pgratz1/pcie-matmul-rtl2gds/docs/session-logs/README.md

# Session logs

Full transcripts of the multi-agent run that took this design from an empty
repository to a signed-off GDS-II. Rendered from the raw Claude Code session
transcripts into readable Markdown.

**3,042 turns across eight participants.** Tool output is truncated at 2,500
characters per call and long text blocks at 20,000; model reasoning is preserved
in collapsed `<details>` blocks. Credentials are redacted.

| Log | Participant | Phases | Turns |
|-----|---|---|---|
| [00-orchestrator.md](00-orchestrator.md) | Orchestrator (main session) | 0–5 | 510 |
| [01-validation-specialist-phase0.md](01-validation-specialist-phase0.md) | validation-specialist | 0 | 104 |
| [02-spec-writer.md](02-spec-writer.md) | spec-writer | 1–3 | 282 |
| [03-rtl-designer.md](03-rtl-designer.md) | rtl-designer | 2–4 | 284 |
| [04-test-writer.md](04-test-writer.md) | test-writer | 2–3 | 483 |
| [05-rtl-reviewer.md](05-rtl-reviewer.md) | rtl-reviewer | 2b | 93 |
| [06-validation-specialist.md](06-validation-specialist.md) | validation-specialist | 3–4 | 743 |
| [07-circuit-designer.md](07-circuit-designer.md) | circuit-designer | 4 | 543 |

## How the process worked

The orchestrator wrote no RTL, tests or flow scripts. It delegated to six
subagents, enforced the phase gates in [`CLAUDE.md`](../../CLAUDE.md), and
independently re-verified every gate claim rather than accepting agent reports.

The RTL author and the test author worked **in parallel from the specification
alone**, neither able to see the other's work. That independence is what surfaced
six specification under-determinations in Phase 2 and made the test suite a real
check rather than a restatement of the implementation.

## Where the interesting parts are

- **BUG-007**, the defect that nearly shipped — a Yosys `peepopt` peephole
  mis-compiled legal RTL, so the *synthesized* design computed one matrix row as
  always zero while all 72 RTL tests passed. Found in
  [06-validation-specialist.md](06-validation-specialist.md) during gate-level
  simulation; root-caused in [03-rtl-designer.md](03-rtl-designer.md).
- **BUG-001**, which invalidated a phase of evidence — `make test N=<n>` never
  rebuilt the simulation binary, so every earlier "passes at N=4/N=16" result was
  the N=8 binary re-run. [06-validation-specialist.md](06-validation-specialist.md).
- **Three refuted hypotheses**, each overturned by measurement rather than
  argument: the reviewer's `WIDTHCONCAT` call and its cell-delta theory (both in
  [03-rtl-designer.md](03-rtl-designer.md)), and the orchestrator's own root-cause
  guess for BUG-007.
- **Two spec requirements that were arithmetically impossible** as written,
  caught by the test author being unable to write a test for them
  ([04-test-writer.md](04-test-writer.md), [02-spec-writer.md](02-spec-writer.md)).

See [`../phase-reports/summary.md`](../phase-reports/summary.md) for the sign-off
summary, final numbers, and what the process would change next time.
