pgratz1/pcie-matmul-rtl2gds/docs/phase-reports/phase2-review-round2.md

# Phase 2b RTL Review — Round 2 (deltas only) — `rtl/` v. `docs/spec.md` 1.1.2

## Blocking

**None.** All six round-1 items are correctly actioned, the `mem_c` reset rewrite is exhaustively correct at every legal `N`, and the `cfg_len_ok` reasoning holds as claimed. Nothing in the rework disturbs anything I verified clean in round 1.

## Should fix

1. **`rtl/mem_c.sv:92-94` — the +1,178 cell delta is most plausibly here, not in `cfg_len_ok`.** The loop index is `ri[BOW-1:0] * BOW'(N*ACCW)` where `ri` is a module-scope `integer` (`mem_c.sv:81`). That is a *sized arithmetic expression on a variable*, which is exactly the form that discourages constant folding; if Yosys does not fold it, the reset branch synthesises a second variable-offset row-write decoder alongside the existing `d_boff` one at `mem_c.sv:96`. At N=8 that decoder spans 8 rows × 256 bits — the right order of magnitude for ~1,200 combinational cells at unchanged flop count. The alternative explanations do not add up: `cfg_len_ok` is one 10-bit equality (~10 cells) and the deleted sinks were already dead-code-eliminated. Diagnostic: `yosys -p "read_verilog -sv $(cat rtl/filelist.f); hierarchy -top matmul_top; synth; select mem_c; stat"`. Fix, behaviour-identical: declare the variable in the block and drop the casts — `for (int ri = 0; ri < NROW; ri++) mem[ri*N*ACCW +: N*ACCW] <= '0;` — which elaborates to `NROW` constant part-selects. Area only; forward to the Phase 4 brief if not taken now.
2. **REQ-126 and REQ-123 are claimed by no module header.** `tlp_rx.sv:36-41` implements REQ-126 at `tlp_rx.sv:198,221` but does not claim it; `matmul_top.sv:48` claims REQ-122 but not its companion REQ-123 (which `mm_ctrl`/`reg_file` jointly satisfy). Item 6 of the rework added 13 claims and missed the two newest. Comment-only.
3. **`rtl/mm_array.sv:61-65`** — the `UNUSEDSIGNAL` suppression wraps the whole `a_o`/`b_o`/`v_o` declarations, not just the edge bits that are unread by construction. A future mis-index of the chain at `mm_array.sv:82-83,90-91` would no longer be caught by lint. Verilator offers no narrower scope, so accept it, but the loss of coverage on those three vectors is real and should be recorded.

## Coverage gaps

- **REQ-042 vs REQ-126 textual overlap** (`docs/spec.md:729-731` vs `:737-749`). REQ-042's antecedent — "a `CfgRd0`/`CfgWr0` whose Device or Function Number is non-zero" — still literally matches a malformed-`Length` request to a non-zero device and forbids `ERR_UNSUP_REQ`, while REQ-126 requires it. REQ-126's closing sentence asserts precedence and the RTL follows REQ-126, so behaviour is unambiguous; but REQ-042's own text was not amended. → spec-writer: add "with `Length` == 1" to REQ-042's antecedent.
- **`rtl/mem_c.sv:79`** — `NROW = (1<<WIW)/N` is an exact tiling only because `N` is a power of two, so `1<<$clog2(N*N) == N*N`. Guaranteed by §14, but the code carries no note; a non-power-of-two `N` would leave the tail of `mem` unreset with no lint or test failure. → rtl-designer: one-line comment, optional.

## Verified clean

- **`mem_c` reset coverage (item 1) — exhaustive, no off-by-one.** Because `N` is a power of two, `1<<WIW == NW == N*N` exactly, so `NROW == N` and the `N` fills of `N*ACCW` bits tile `MEMBITS` with no gap and no overlap. Checked every legal `N`: N=2 → MEMBITS 128, NROW 2, row 64 b, last fill 64+64=128; N=4 → 512, 4, 128 b, 384+128=512; N=8 → 2048, 8, 256 b, 1792+256=2048; N=16 → 8192, 16, 512 b, 7680+512=8192; N=32 → 32768, 32, 1024 b, 31744+1024=32768. `BOW` (7/9/11/13/15) never truncates the offset product at any `N`. Every word of `mem_c` is cleared; §13.4 and REQ-092 hold.
- **`cfg_len_ok` (item 3) — the structural claim is correct, verified independently.** A config TLP with `Length != 1` fails the guard at `tlp_rx.sv:221`, then fails `is_mem && fmt_3dw` at `:225` (`ttype == 5'b00100`), and lands on the terminal `else` at `:229`. There `posted = is_msg || ((is_mem||is_io) && fmt_wr)` is 0 for `ttype == 00100` on all three terms, so it resolves to `CLS_UR_ERR`, and `ev_unsup_req` at `:233` pulses on exactly that class — REQ-126(a) and (d). `cfg_req_valid` is asserted only in `S_CFGACC`, which is unreachable from `CLS_UR_ERR`, so no config register is touched and `cid` is not captured — REQ-126(b), consistent with REQ-052's "accepted" wording. The devfn test is inside the accepted branch, so the REQ-042 carve-out is bypassed as REQ-126 requires. Drain: `after_hdr` sends a `CfgWr0` (payload present, so no `eop` on DW2) to `S_DRAIN`, which holds `rx_tlp_ready` high and consumes to `eop` before `S_CPL` — REQ-126(c), no desynchronisation; a `CfgRd0` with bad `Length` has `eop` on DW2 and goes straight to `S_CPL`. Checked `Length` = 0 (1024 DW) and `Length` = 1023: both drain correctly. The UR header matches REQ-126's worked example bit-for-bit: `tlp_tx.sv:101-115` yields DW0 `0x0A000000` (Fmt 000/Type 01010, Length 0) and DW1 `0x00002004` (CID 0, Status 001, BCM 0, Byte Count 4).
- **REQ-122 (`D_WR` = 1, invariant).** All four region strobes (`app_bar0.sv:141-144`) are combinational from the accepted payload beat and commit on the edge ending it, so `t_commit = t_beat + 1` regardless of region, burst position, Byte Enables or `N`. The one path that could have made it region-dependent — `mem_c`'s drain-over-host priority at `mem_c.sv:95-97` — cannot drop a host write, because `c_wr` is gated `&& !eng_busy` and `d_wr_en` only asserts while busy.
- **REQ-123 (`t_beat + 4N + 2`, no `D_WR` term).** `reg_file.sv:112` drives `start` combinationally from the write beat, so `t_start == t_beat`; `mm_ctrl` enters `PRIME` on the edge ending `t_beat`, `done_set` asserts on the last `DRAIN` cycle `t_beat+4N+1`, and `STATUS.DONE` reads 1 during `t_beat+4N+2` (34 at N=8). `PERF_CYCLES` independently latches `cyc_cnt+1 = 4N+2`. Agrees with REQ-074/101 with no double-count.
- **REQ-124.** `reg_file.sv:115` suppresses `start_while_busy` at source when bit 1 is also set; `ERR_START_BUSY` reads 0 afterwards, and `soft_reset` takes full effect. Matches REQ-124's "not observable / not constrained" framing.
- **REQ-125.** `clr_acc = (state == ST_PRIME) || soft_reset` (`mm_ctrl.sv:214`) and `c_wr_en = (state == ST_DRAIN)` mean the row in flight on the `soft_reset` cycle still commits, with the correct `acc_south` value (the PE clear happens on the same edge but `acc_out` is the pre-edge register). Rows are written whole, so every `mem_c` word holds either its pre-operation value or its correct new value — never a partial or undefined one.
- **`tlp_tx.sv:160-163`** — `tx_tlp_data` now forced to `32'h0` under `rst` alongside sop/eop/valid; §13.4 reset row satisfied. No latch introduced (all four outputs still have unconditional defaults at `:132-135`).
- **Port removal (item 5)** — `rdata_last` gone from `app_bar0`'s port list; `rd_last_r` retained internally (`app_bar0.sv:108`) and still drives the `S_RD` exit, so the read burst still terminates correctly. `matmul_top` has no sink net left, restoring strict REQ-011.
- **Suppressions (item 2)** are as narrow as described: `mm_array.sv:61-65`, `tlp_rx.sv:139-142`, `pcie_cfg_space.sv:43-45` each wrap declarations only, each has a one-line justification, and each covers a signal that is genuinely unread by construction — `dw0_r`/`dw2_r`'s ignored header bits are the §7.2.1/7.2.2 don't-cares, and `req_wdata[13:8]` lands on RO-0 config fields. None hides a signal that should be driving something.
