pgratz1/pcie-matmul-rtl2gds/docs/bugs.md

# Bug ledger — PCIe-attached matrix multiplier

Owner: validation-specialist (CLAUDE.md "Ownership and independence rules").
Opened during Phase 3 validation.

Format: `BUG-nnn | test | REQ ids | status | symptom | root cause | fix | files`

Status values: `OPEN`, `ROUTED-rtl`, `ROUTED-test`, `ROUTED-spec`, `CLOSED`,
`CLOSED-nofix` (investigated, no defect).

**Close-out policy.** A bug is only marked `CLOSED` after I have re-verified it
independently of the owner's report. For the three "a test assumed `N` = 8
magnitudes" bugs (002, 003, 005) a passing test is *not* sufficient evidence —
a test can pass because it now checks less. Each of those was closed only after
**mutation testing**: a deliberate, lint-clean RTL defect of the exact class the
test exists to catch was injected into a scratch copy of `rtl/`, and the
repaired test was required to **fail**. `rtl/` itself was never modified.

### Mutation set used for close-out

All mutants are lint-clean under `verilator --lint-only -Wall` and live in the
scratchpad, built via `make test VERILOG_SOURCES=<mutant filelist>`.

| ID | Injected defect | File | Kills |
|----|---|---|---|
| M1 | `!eng_busy` dropped from `a_wr`/`b_wr`/`c_wr` — host writes land during an operation | `app_bar0.sv:142-144` | BUG-003's test |
| M2 | `c_wr_row = drn_cnt` instead of `N-1-drn_cnt` — drain rows emitted in reverse | `mm_ctrl.sv:221` | BUG-005's test |
| M3 | drain lanes reversed on the way into storage | `mem_c.sv` | BUG-005's test |
| M4 | a BAR0 write beat immediately following another is dropped | `app_bar0.sv` | **nothing — invalid mutant**, see BUG-002 |
| M5 | a `sop` arriving the cycle after an `eop` is ignored — gapless TLPs misframed | `tlp_rx.sv:349` | BUG-002's test |
| M6 | `rx_tlp_ready` held low 40 cycles after every `eop` — pushes a write beat outside the BUSY window | `tlp_rx.sv:161` | BUG-003's positioning guard |
| M7 | `len_ok` accepts `Length` field 0 | `tlp_rx.sv:200` | REQ-127's test |
| M8 | `len_ok` accepts decoded length > 32 | `tlp_rx.sv:200` | REQ-127's test |

---

## BUG-001 — `make test N=<n>` silently reuses a stale `sim.vvp`

| field | value |
|---|---|
| **test** | whole suite; `tb/Makefile` |
| **REQ ids** | REQ-113 (`matmul_top` parameterizable for every legal `N`), and the Phase 3 gate's "100% of tests pass" (which was only ever measured at `N` = 8) |
| **status** | **`CLOSED` 2026-09-11** |
| **found by** | Noticing that 16 consecutive `make -C tb test N=<2,4,8,16>` runs all took 19–20 s and never changed `tb/sim_build/sim.vvp`'s mtime. |

**Symptom.** `make -C tb test N=2` reports `TESTS=71 PASS=71 FAIL=0`. After
`make -C tb clean`, the identical command reports `PASS=69 FAIL=2`. The `N`
override had no effect at all; every "sweep" run was the previously built
`N = 8` binary.

**Root cause.** cocotb's `Makefile.icarus` declares
`$(SIM_BUILD)/sim.vvp: $(VERILOG_SOURCES) ...`. `N` reaches the compile through
`COMPILE_ARGS += -P$(COCOTB_TOPLEVEL).N=$(N)` (tb/Makefile line ~76), which is
**not** a prerequisite of that rule. When the RTL sources are unchanged, make
considers `sim.vvp` up to date and re-runs the old binary under the new `N=`
variable. The same hazard applies to `SEED` (harmless, `SEED` is read at
runtime) and to any future `COMPILE_ARGS` knob (not harmless).

This is why `rtl/README.md` can truthfully say "clean at N = 2, 4, 8, 16 and
32" — `make lint` and `make elab-sweep` re-invoke verilator/iverilog every time
and are unaffected — while the *simulation* at those `N` had never actually
run.

**Fix (recommended, for test-writer).** Make the build depend on the
parameterization, e.g. stamp `N` into the build directory
(`SIM_BUILD := $(TB_DIR)/sim_build/n$(N)`), or add an order-only prerequisite
file whose contents are `$(N)`. A `SIM_BUILD` per `N` also lets the `N` sweep
run in parallel.

**Files.** `tb/Makefile`.

**Impact.** This bug is what hid BUG-002 and BUG-003. It is the single most
important finding of Phase 3: the gate criterion "100% of tests pass" was being
evaluated against a binary that did not correspond to the requested
configuration.

### Close-out verification (validation-specialist, 2026-09-11)

**Fix as delivered.** `SIM_BUILD := $(TB_DIR)/sim_build/$(SIM)-n$(N)` with
`COCOTB_RESULTS_FILE := $(SIM_BUILD)/results.xml`, plus a `check-build-id`
prerequisite on `sim-guard` and a `make build-id` reporter.

**Verified functionally.** Deleted `tb/sim_build` entirely, then ran
`make test N=<n> TEST=test_smoke` for n = 2, 4, 8, 16 with **no `make clean`
anywhere**. Four separate binaries were produced and all four passed:

| `N` | `sim.vvp` md5 (first 12) | result |
|---|---|---|
| 2 | `688715e0a6ab` | 4/4 |
| 4 | `b3a594814a14` | 4/4 |
| 8 | `0f7196821ba8` | 4/4 |
| 16 | `63f5e5169130` | 4/4 |

4 distinct hashes from 4 runs; 4 isolated `results.xml`. These match the hashes
the orchestrator reported, arrived at independently.

**Guard attacked, per the brief.** Seven attempts to make `check-build-id`
accept a `SIM_BUILD` that does not encode `N`:

| Attempt | Outcome |
|---|---|
| `SIM_BUILD=/tmp/att-nope N=2` | blocked |
| `SIM_BUILD=.../icarus-n8 N=2` (another `N`'s dir) | blocked |
| `SIM_BUILD=/tmp/att-n2/ N=2` (trailing slash) | blocked |
| `SIM_BUILD=/tmp/att-n32 N=2` (suffix-collision attempt) | blocked |
| `SIM_BUILD=/tmp/att-n2 N=32` (reverse collision) | blocked |
| `SIM_BUILD=.../icarus-n2 N=2` | allowed — correct, encodes `N` |
| `SIM_BUILD=/tmp/junk-n2 N=2` | allowed — correct, encodes `N` |

The `*n$(N)` suffix glob is not defeatable by the legal `N` values: no two of
`n2, n4, n8, n16, n32` are suffixes of one another. The guard is real, not
decorative.

**One residual hole, reported not reopened.** `check-build-id` hangs off
`sim-guard`, which is a prerequisite of `test` (and therefore of `waves`). It is
**not** a prerequisite of `sim`, the target cocotb's `Makefile.sim` contributes.
`make -C tb sim N=2 SIM_BUILD=/tmp/bypass-nope` runs unguarded and builds in
`/tmp/bypass-nope` — confirmed empirically. This is narrow: `sim` is not a
documented entry point (`CLAUDE.md` and the Makefile's own `usage` text list
only `lint`/`test`/`waves`/`elab-sweep`), and even via `sim` the *default*
`SIM_BUILD` still encodes `N`, so a user must explicitly override `SIM_BUILD`
to hurt themselves. **Suggested one-line follow-up for test-writer:
`sim: check-build-id`.** Not a reason to hold the bug open.

**Closed.** The hazard is fixed, the guard works on every documented path, and
the `N` sweep now genuinely tests what it claims.
---

## BUG-002 — `test_tlp_back_to_back_tlps_no_idle_cycles` hard-codes 16 DWORDs into `mem_c`

| field | value |
|---|---|
| **test** | `tb/tests/test_tlp.py::test_tlp_back_to_back_tlps_no_idle_cycles` (line ~771) |
| **REQ ids** | test cites REQ-005/REQ-013/REQ-022; the behaviour it trips over is REQ-091 |
| **status** | **`CLOSED` 2026-09-11** |
| **found by** | Full suite at `N = 2` after `make clean` (BUG-001), SEED = 1, 7, 424242, 20260910 — fails on all four, so it is deterministic, not seed-dependent. |

**Symptom.**
```
AssertionError: REQ-022: DWORD(s) [4, 5, 6, 7, 8, 9, 10, 11, 12, 13, 14, 15]
did not land when the 16 single-DWORD MWr TLPs were issued one at a time ...
read back 0000111101001111020011110300111100000000...0
```
DWORDs 0–3 land correctly; 4–15 read back as zero.

**Root cause — in the test, not the DUT.** The test does
`pattern = [0x11110000 + k for k in range(16)]` and `base = G.MEM_C_BASE`,
i.e. it writes 16 DWORDs into the C region unconditionally. `mem_c` holds
`N*N` words (spec §9.2, §11.3). At `N = 2` that is **4** words, so DWORDs 4–15
are at BAR0 offsets ≥ `0x3010` which REQ-091 makes RAZ/WI. The DUT is doing
exactly what REQ-091 requires. The constant 16 happens to be ≤ `N*N` for
`N` ≥ 4, which is why the bug only appears at `N = 2`.

**Fix (recommended, for test-writer).** The test already calls `discover_n(tb)`
and throws the result away. Scale the burst: `count = min(16, n * n)` (or pick
a region that is `N`-independent — the `reg_file` region is 4 KiB for every
`N`). **Do not** relax the assertion.

**Files.** `tb/tests/test_tlp.py`.

### Close-out verification (validation-specialist, 2026-09-11)

**Fix as delivered.** The 16 writes cycle through implemented C words
(`word = k mod N*N`), so the TLP count — and therefore the back-to-back stress
— is identical at every `N`, and several TLPs now target the same address.

**Verified it still catches its bug class, not just that it passes.** A test
that passes because it checks less would be worse than the original, so the
repaired test was run against deliberately broken RTL.

- **M4 (first attempt) — survived, and the mutant was wrong, not the test.**
  I first injected "drop a BAR0 write beat that immediately follows another
  write beat". The test passed. Root cause of the *mutant's* failure: for
  single-DWORD `MWr` TLPs the payload beats are separated by three header
  beats, so `wr_beat` is never asserted on two consecutive cycles and the
  mutation is unreachable. Recorded because a surviving mutant must be
  explained, not ignored.
- **M5 — killed at `N` = 2 and `N` = 8.** Injected into `tlp_rx.sv:349`: a
  `sop` arriving on the cycle immediately after an `eop` is ignored, which is
  precisely the gapless-framing property (REQ-005/REQ-020) this test exists to
  protect. The test failed at both `N` with the on-point diagnostic:
  > `REQ-005/REQ-013: C word(s) [0, 1, 2, 3] of 4 did not take effect when 16
  > single-DWORD MWr TLPs were presented back-to-back with no idle cycle
  > between eop and the next sop (the identical writes with idle cycles
  > between them all landed).`

The repaired test keeps its teeth and its error message still names the right
requirement. Also passes unmodified at `N` = 2, 4, 8, 16.

**Closed.**
---

## BUG-003 — `test_matmul_write_abc_while_busy` assumes the operation outlives the TLP stream

| field | value |
|---|---|
| **test** | `tb/tests/test_matmul.py::test_matmul_write_abc_while_busy` (line ~167) |
| **REQ ids** | REQ-062, REQ-101/REQ-123 |
| **status** | **`CLOSED` 2026-09-11** |
| **found by** | Full suite at `N = 2` after `make clean`; root-caused from an FST dump correlating `rx_tlp_*` beats with `eng_busy` and `eng_c_wr_en`. |

**Symptom.** `C after A/B/C writes were attempted while BUSY: 1 of 4 elements
differ: [0][0]: DUT -1 != golden -5720`. `-1` is `0xFFFFFFFF`, the value the
test wrote. The companion assertions in the same test (`ERR_WRITE_BUSY` set,
`mem_a` preserved) both **pass**.

**Root cause — in the test, not the DUT.** The test issues one burst of four
TLPs: `CTRL.START`, then `MWr` to A, B and C. Each single-DWORD `MWr` is 4
beats, so the payload beats land roughly 4 cycles apart. An operation takes
`4N + 2` cycles (REQ-101), which at `N = 2` is **10** cycles — shorter than the
TLP stream that is trying to race it. Waveform, `N = 2`, SEED = 7
(period 10 ns):

| time | event | `eng_busy` |
|---|---|---|
| 4250 ns | `CTRL.START` payload beat | 0 → 1 next cycle |
| 4300 ns | `MWr` A payload beat (`addr 0xc0001000`, `0xFFFFFFFF`) | **1** → discarded, `ERR_WRITE_BUSY` set |
| 4350 ns | `MWr` B payload beat (`addr 0xc0002000`) | **1** → discarded |
| 4330, 4340 ns | `eng_c_wr_en` — both rows of C drained | 1 |
| 4350 ns | `eng_busy` → 0 (operation complete, `4N+2 = 10` cycles after 4250) | |
| 4400 ns | `MWr` C payload beat (`addr 0xc0003000`, `0xFFFFFFFF`) | **0** |

The C write arrives 5 cycles **after** `BUSY` fell. REQ-062 gates the discard
on `STATUS.BUSY == 1`; `BUSY` was 0, so accepting the write is the specified
behaviour, and it lands on top of the already-drained `C[0][0]`. At `N = 8`
the operation is 34 cycles and still running when the C write arrives, which
is why the test passes there.

**Fix (recommended, for test-writer).** Make "still busy" an explicit
precondition rather than an accident of `N`: either hold `rx_tlp_ready`-side
pacing so all three writes are in flight before `4N+2` elapses, or read
`STATUS` between the writes and assert `BUSY == 1` at the moment of each write,
or drive the three A/B/C writes as **one** multi-DWORD burst instead of three
TLPs. **Do not** drop the C check or widen the tolerance.

**Files.** `tb/tests/test_matmul.py`.

### Close-out verification (validation-specialist, 2026-09-11)

**Fix as delivered.** Each region is raced separately against a fresh `START`,
and the shim's recorded beat cycles now assert
`1 <= t_write - t_start <= 4*N + 2`.

**The specific thing I flagged was "the test silently tests nothing when the
operation has already finished". That is the claim I verified, and a passing
run cannot demonstrate it** — I had to make the write land outside the window
and confirm the test *fails loudly* rather than passing.

- **M6 — the positioning guard fires.** Injected into `tlp_rx.sv:161`:
  `rx_tlp_ready` held low for 40 cycles after every `eop`. This is legal
  sink behaviour under REQ-002, so nothing else breaks; it simply pushes the
  poison write's payload beat far past the BUSY window. At `N` = 2 **and**
  `N` = 8 the test failed with exactly the intended message:
  > `test positioning: the mem_a write's payload beat transferred 45 cycles
  > after the CTRL.START beat, outside the BUSY window [1, 4*N+2 = 10] that
  > REQ-074 defines. REQ-062 only applies while STATUS.BUSY is 1, so this run
  > would not have exercised it.`

  Under the old test this exact situation was a silent pass. The hole is
  genuinely closed: the degenerate case is now a loud, self-explaining failure.
- **M1 — the requirement itself is still checked.** `!eng_busy` removed from
  `a_wr`/`b_wr`/`c_wr` in `app_bar0.sv:142-144`, so host writes land during an
  operation in violation of REQ-062. Test failed at `N` = 2 and `N` = 8.

Both halves verified: the test still detects a real REQ-062 violation (M1) and
it now refuses to pass vacuously (M6).

**Closed.**
---

## BUG-004 — spec has no requirement for `Length` > 32 or `Length` field = 0 inside the BAR0 window

| field | value |
|---|---|
| **test** | none exists; found by scratchpad probe `p_length_over_32_and_zero` |
| **REQ ids** | gap between REQ-044, REQ-056 and §4.5 |
| **status** | **`CLOSED` 2026-09-11** |
| **found by** | Directed probing of boundary arithmetic (Phase 3 task b). |

**The gap.** Three statements do not compose:

- **§4.5** makes `max_read_request_size = 0` (≤ 32 DW) an obligation on the
  *testbench*, not on the DUT.
- **REQ-056** says `app_bar0` "shall accept bursts of 1 to 32 DWORDs" — it does
  not say what happens to a 33rd.
- **REQ-044** makes a request Unsupported only when
  `offset + Length*4 > 16384`.

So an `MRd` at BAR0+`0x3000` with `Length` = 33 (132 B, ends at `0x3084`) or
with the `Length` field = 0, which PCIe Base r6.0 §2.2.1 defines as **1024
DWORDs** (4096 B, ends at exactly `0x4000` = 16384, so REQ-044's strict `>`
is *not* satisfied) is inside the window by REQ-044's own arithmetic, and no
requirement says the DUT may refuse it.

**What the RTL does** (`rtl/tlp_rx.sv:200`):
```systemverilog
assign len_ok = (len_raw != 10'd0) && (len_raw <= 10'd32);
```
`len_ok` false ⇒ `CLS_UR_ERR` for non-posted / `CLS_DROP_ERR` for posted.
Measured at `N = 8`: `Length` = 33, 64 and 0 all return
`status = UR, length = 0, byte_count = 4`, and framing is preserved (the next
TLP parses correctly). Note `Length` field 0 is treated as *zero* DWORDs by
the `len_raw != 0` term, not as 1024, but the outcome is the same UR.

**Why it matters beyond pedantry.** REQ-126 was added in v1.1.2 for exactly
this shape of problem on the *configuration* path (`CfgRd0`/`CfgWr0` with
`Length` != 1). The memory path has the same hole and no equivalent
requirement, so the RTL's behaviour here is unverified by construction — the
suite cannot test it because the spec never states it.

**Recommendation (not a decision).** Add a REQ that states the DUT's existing
behaviour: a memory request whose `Length` field is 0 or greater than 32 is
Unsupported — UR Completion for non-posted, discard for posted, `ERR_UNSUP_REQ`
set in both cases — and note that `Length` = 0 is handled as out-of-range
rather than decoded as 1024 DW. That is a one-line spec amendment and **no RTL
change**. spec-writer decides; validation does not.

**Files.** `docs/spec.md` §7.6 (and §9.2/REQ-056 cross-reference);
`rtl/tlp_rx.sv:200` for reference only.

### Close-out verification (validation-specialist, 2026-09-11)

**Fix as delivered.** Spec v1.1.4 adds **REQ-127** (`docs/spec.md` §7.6) with
clauses (a)–(e), and narrows REQ-044's antecedent to `1 <= L <= 32` so the two
are disjoint by construction rather than by tie-break. I asked for a decision,
not a particular decision; the spec adopted the RTL's existing behaviour, so
**no RTL change was required** — which is what I recommended and, more
importantly, what the evidence supported.

**Read the requirement against the RTL myself.** `Length` field 0 decoding to
1024 DW (not zero) is now explicit, and `tlp_rx.sv:200`
(`len_ok = (len_raw != 0) && (len_raw <= 32)`) rejects it either way, so the
implementation satisfies REQ-127 for both the `Length`=0 and the 33..1023 cases.
Clause (e) holds on the posted path too because `ev_unsup_req` fires on both
`CLS_UR_ERR` and `CLS_DROP_ERR`.

**Verified the new test is not vacuous.** `test_tlp_over_length_memory_request`
passes at `N` = 2 and `N` = 8, and was mutation-tested:

| Mutant | Injected | Result |
|---|---|---|
| M7 | `len_ok = (len_raw <= 32)` — `Length` field 0 accepted | test **FAILS** |
| M8 | `len_ok = (len_raw != 0)` — decoded length > 32 accepted | test **FAILS** |

Both halves of the requirement's antecedent are genuinely covered.

**My own probe `p_length_over_32_and_zero` is now redundant** with a real test
in `tb/`, which is the right outcome — the coverage moved from my scratchpad
into the suite.

**Closed.**
---

## BUG-005 — `test_matmul_c_addressing_and_persistence` builds an A matrix outside INT8 range at `N` >= 16

| field | value |
|---|---|
| **test** | `tb/tests/test_matmul.py::test_matmul_c_addressing_and_persistence` (line 338) |
| **REQ ids** | spec §12.6 (operands are INT8, `-128 <= v <= 127`); test cites REQ-089/090/092/098 |
| **status** | **`CLOSED` 2026-09-11** |
| **found by** | Full suite at `N` = 16 after `make clean` (BUG-001). Deterministic, seed-independent. |

**Symptom.**
```
File "tb/models/golden.py", line 130, in matmul_golden
  assert all(-128 <= v <= 127 for v in row), "A outside INT8 range (spec 12.6)"
AssertionError: A outside INT8 range (spec 12.6)
```
The DUT is never stimulated; `matmul_golden` rejects the stimulus first. The
testbench's own guard caught this correctly — that guard is working as designed.

**Root cause — in the test, not the DUT.** Line 338:
```python
a = [[(i * n + j) - 100 for j in range(n)] for i in range(n)]
```
`i*n + j` ranges over `0 .. N*N-1`, so the values run `-100 .. N*N-101`:

| `N` | max A value | INT8 legal? |
|---|---|---|
| 2 | -97 | yes |
| 4 | -85 | yes |
| 8 | -37 | yes |
| 16 | **155** | **no** |
| 32 | **923** | **no** |

The constant `100` is tuned for `N` = 8 and nothing scales it.

**Note for the fix — the test's premise also breaks at `N` = 32.** The
docstring's argument is "distinct values per element so that any transposition
or row reversal shows up". INT8 has exactly 256 distinct values, so a
fully-distinct `N*N` element pattern exists at `N` <= 16 (`(i*n + j) - 128` is
exact at `N` = 16) but is **impossible** at `N` = 32, where `N*N` = 1024.
The permutation-sensitivity argument needs restating for `N` = 32 — for example
`A[i][j] = ((i * 37 + j * 5) % 251) - 125`, which is not fully distinct but is
still sensitive to any row or lane permutation, or check the placement property
directly with `A[i][j] = i - 128` in one pass and `A[i][j] = j - 128` in a
second. **Do not** simply clamp or modulo the existing expression without
re-establishing that the permutation check still has teeth.

**Files.** `tb/tests/test_matmul.py` line 338.

### Close-out verification (validation-specialist, 2026-09-11)

**Fix as delivered.** The single `N`=8-tuned pattern is replaced by three
INT8-legal patterns: `A[i][j] = i-128` (row-varying), `A[i][j] = j-128`
(lane-varying) and `A[i][j] = ((i*37 + j*5) % 251) - 125` (two-index).

**The concern was that dropping per-element distinctness weakens the
permutation check.** The fix's own rationale is sound — INT8 has 256 values and
C has 1024 elements at `N` = 32, so distinctness is impossible there — but
rationale is not evidence, so I mutation-tested the property directly.

| Mutant | Injected defect | `N` = 2 | `N` = 8 |
|---|---|---|---|
| M2 | `c_wr_row = drn_cnt` instead of `N-1-drn_cnt` (`mm_ctrl.sv:221`) — drain rows emitted in reverse order, i.e. exactly the REQ-098 row-permutation failure | **FAIL** | **FAIL** |
| M3 | drain lanes reversed inside `mem_c` — the lane-permutation failure | **FAIL** | **FAIL** |

Row permutation and lane permutation are both still detected, at small `N` as
well as at `N` = 8, so the three complementary patterns really do cover what the
one distinct pattern used to. The test also now passes at `N` = 16, which it
could never reach before (it aborted in the golden model).

**Closed.**
---

## BUG-006 — `Host.OP_TIMEOUT_NS` is a fixed 20 us and does not scale with `N`

| field | value |
|---|---|
| **test** | `tb/models/host.py:38`; affects every helper that calls `mem_read`/`mem_write`/`enumerate` |
| **REQ ids** | REQ-002, REQ-007 (the DUT is allowed to be stalled for an *unbounded* number of cycles; the harness is not prepared for it) |
| **status** | **`CLOSED` 2026-09-11** |
| **found by** | Scratchpad probe `p_heavy_random_backpressure` at `N` = 16. |

**Symptom.** `Exception: Timeout` from `cocotbext.axi.address_space.read`,
raised inside `read_c()`, during a 90%/90% random-backpressure run at `N` = 16.

**Root cause — in the harness, not the DUT.** `read_c(tb, n)` issues a single
`window.read(0x3000, 4*N*N)` under one `OP_TIMEOUT_NS = 20000` ns budget.
`cocotbext-axi` splits that into `ceil(4*N*N / 128)` sequential 32-DWORD
requests *inside the same timeout*. At `N` = 16 that is 1024 bytes = 8
completions = ~280 beats; at 10% effective throughput it needs well over
2000 cycles = 20 us, so the fixed budget expires.

**Proof that the DUT is not at fault.** Same design, same `N` = 16, same seed:

| stimulus | result |
|---|---|
| 50% / 50% backpressure, whole-C read | **PASS** |
| 75% / 75% backpressure, whole-C read | **PASS** |
| 90% / 90% backpressure, C read in 32-byte chunks | **PASS** |
| 90% / 90% backpressure, whole-C read in one call | Timeout |

Only the shape of the *readback* changes between the last two rows. The DUT
delivers every byte correctly in all four.

**Why it is worth fixing anyway.** The margin shrinks as `N` grows. At `N` = 32
a whole-C read is 4096 bytes = 32 back-to-back completions ≈ 1120 beats
≈ 11.2 us at **zero** backpressure, against a 20 us budget; `test_stress`
already runs at 15% stall by default. This is a flake waiting to happen in the
one configuration that takes an hour per run to reproduce.

**Fix (recommended, for test-writer).** Scale the budget with the transfer,
e.g. `timeout = OP_TIMEOUT_NS + 40 * length` ns, or make `OP_TIMEOUT_NS` a
function of `N`. Do **not** lower the backpressure probabilities to fit the
timeout.

**Files.** `tb/models/host.py` line 38 and its three call sites (lines 194,
257, 267).

### Close-out verification (validation-specialist, 2026-09-11)

**Fix as delivered.** `op_timeout_ns(length) = 20 us + 40 ns/byte`, applied in
`mem_read`, `mem_write` and `raw_request`. Backpressure probabilities unchanged
— the fix widened the budget rather than reducing the stimulus, which is the
right direction and the one I asked for.

**Verified with the exact artifact that originally failed.** I re-ran my
**unmodified** scratchpad probe `probe_bp` at `N` = 16 — the same module, same
90%/90% `rx_gap_prob`/`tx_stall_prob`, same whole-C single-call readback that
produced `Exception: Timeout` during the original investigation:

```
probe_bp.p_tx_stall_mid_completion_burst   PASS
probe_bp.p_heavy_random_backpressure       PASS   <-- previously Timeout
probe_bp.p_tx_stall_across_start           PASS
TESTS=3 PASS=3 FAIL=0
```

The probe was not edited in any way between the failing and passing runs, so the
change in outcome is attributable to the harness fix alone.

**Closed.**
---

## BUG-007 — PE row 6's `a_reg` is absent from the synthesized netlist; C row 6 is always zero

| field | value |
|---|---|
| **test** | `test_regs::test_reg_soft_reset`, `test_regs::test_reg_start_and_soft_reset_while_busy` (gate-level); scratchpad probes `p_gl_ab_readback_then_matmul`, `p_gl_drain_vs_compute` |
| **REQ ids** | REQ-105 (C = A×B), REQ-089/REQ-098 (drain), REQ-085/REQ-086 (`mem_a` operand delivery) |
| **status** | **`CLOSED` 2026-09-11** (was `ROUTED-circuit-designer`; re-routed to rtl-designer once the cause was found to be a Yosys `peepopt` mis-transformation of legal RTL) |
| **found by** | Phase 4 gate-level simulation of `results/sky130hd/pcie_matmul/base/6_final.v`. |

**Symptom.** At gate level, a matrix multiply returns the correct product in
every row of C except **row 6**, which is all zeros. Deterministic: reproduced
on 3 independent random operand pairs, at two different seeds, **both with and
without SDF back-annotation**. The same tests pass at RTL (the RTL suite is
72/72 at N=8).

```
AssertionError: C before SOFT_RESET: 8 of 64 elements differ (REQ-105).
    [6][0]: DUT 0 != golden -12
    [6][1]: DUT 0 != golden -4
    ... rows 0-5 and 7 all exactly correct ...
```

**Triage, in order.**

1. **Not the host write path.** `mem_a` and `mem_b` were read back byte-for-byte
   before `CTRL.START`: `A readback: 0/64 bytes wrong`, `B readback: 0/64 bytes
   wrong`. The operands are in the device.
2. **Not a lost drain write.** Every C word was pre-loaded with a sentinel
   before the operation. After the operation row 6 contained **zeros, not the
   sentinel** — so the drain write for row 6 *did* fire, and what it wrote was
   zero. The accumulators in PE row 6 were zero at drain time.
3. **Not SDF / timing.** Identical failure with `+sdf=` and with no
   back-annotation at all. Icarus implements no timing checks in any case.
4. **Not X-propagation.** The residual X in the netlist is 256 anonymous
   internal nets of the 64 adder macros, static and never reaching a flop or an
   output (see the Phase 4 report). C row 6 reads a clean 0, not X.

**Root cause, localized.** The A-operand pipeline register of every PE in row 6
does not exist in the netlist. A static census of instance names:

| row | `a_reg` nets | PE flop instances | surviving PE signals |
|---|---|---|---|
| 0–5 | 56 each | 383 each | `acc_reg a_reg b_reg prod v_in v_out v_reg` |
| **6** | **0** | 327 | `acc_reg b_reg prod v_in v_out v_reg` — **no `a_reg`** |
| 7 | 56 | 319 | `acc_reg a_reg prod v_in v_out v_reg` |

With no `a_reg`, row 6 never receives an A operand, every product is 0, the
accumulators stay 0, and the drain faithfully writes zeros.

(Row 7's lower flop count is *not* the defect: the east-edge `a_out`/`v_out` of
the last column legitimately has no consumer, which `rtl/README.md` already
documents as one of the three `UNUSEDSIGNAL` suppressions. Row 7 computes
correctly.)

**Introduced by synthesis, not by place-and-route.** The same census on
`results/sky130hd/pcie_matmul/base/1_2_yosys.v` — the Yosys output, before
floorplan — already shows `g_row[6]` with **0** `a_reg` nets while all seven
other rows have 56. The defect exists at the synthesis boundary. P&R faithfully
implemented what it was given.

**Why 71 RTL tests and the Phase 4 smoke test all missed it.** `test_smoke_single_multiply`
sets exactly one non-zero operand, `A[0][0]=7`, `B[0][0]=6`, so every element of
C except `C[0][0]` is *expected* to be zero. A permanently-zero row 6 is
indistinguishable from a correct result. **The Phase 4 gate's floor — "at least
the smoke test" — passes on this netlist.** That is the finding behind the
finding: the gate as written would have signed off a chip that computes the
wrong answer for 1/8 of every matrix.

**Recommended next step (circuit-designer / rtl-designer, not validation).**
Reproduce at the Yosys stage alone and bisect the synthesis script — start by
checking whether `a_reg` in row 6 is being removed by an optimization pass that
mis-identifies it as unloaded, since row 6 is adjacent to row 7 whose `a_out`
genuinely *is* unloaded. That adjacency is the obvious suspect and it is
testable in minutes with `yosys -p "... ; select -count g_row[6]"`. `rtl/` needs
no change unless that investigation shows otherwise.

**Files.** `results/sky130hd/pcie_matmul/base/1_2_yosys.v` (first appearance),
`6_final.v`; `rtl/mm_array.sv`, `rtl/mm_pe.sv` for reference only.

### BUG-007 close-out verification (validation-specialist, 2026-09-11)

**What the cause actually was.** Not P&R, and not the drain logic I suspected
from the symptom. Yosys lowers a variable bit-offset with a **non-zero constant
base** — `boff = BOW'(gi*N*8) + (BOW'(idx) << 3)` in the old `mem_a.sv:91` — to
a `$shiftx`, and `peepopt`'s `shiftpow2` peephole then rewrites it incorrectly.
The arithmetic was in range (max 504 of 512). **The RTL was legal; the tool was
wrong.** Fixed by selecting the operand byte with an explicit N-way mux over
constant-base slices, in `mem_a.sv` and `mem_b.sv`.

**Pre-fix exposure was wider than the symptom I reported**: `mem_a` lost port 6
at `N`=8, ports 12–13 at `N`=16, ports 24–27 at `N`=32; `N`=2 and 4 were clean.
It worsens with `N`.

#### 1. Negative control — confirmed independently, not taken on report

I rebuilt the pre-fix RTL from `git show HEAD:rtl/<file>` (verified pre-fix:
`mem_a.sv:91` still carries the old `boff` expression), synthesized it, and
replayed the suite against the **synthesized netlist**:

```
pre-fix,  post-synth, N=8:  TESTS=17 PASS=5  FAIL=12   (test_matmul)
post-fix, post-synth, N=8:  TESTS=72 PASS=72 FAIL=0    (whole suite)
```

Every single one of the **80** element mismatches in the negative control is in
**row 6**, all `DUT 0`:

```
[6][0]: DUT 0 != golden 127   [6][4]: DUT 0 != golden -4
[6][1]: DUT 0 != golden 73    [6][5]: DUT 0 != golden 78
...                            [6][7]: DUT 0 != golden -40
row index histogram of all diffs:  80 x [6][
```

This is the same signature I measured on `6_final.v` during the Phase 4 gate-level
run, reproduced from source through an independent synthesis. The control is real.

#### 2. Formal equivalence on the three surviving `$shiftx` sites

`peepopt`/`shiftpow2` **still fires three times at every `N`** after the fix —
the fix removed the *mis-transformed* site, not the peephole. The three
survivors are the host read ports `mem_a.sv:63`, `mem_b.sv:63`, `mem_c.sv:67`,
all of which have a **zero** constant base. Rather than argue from that
difference, I proved it:

```
yosys -p "read_verilog -sv rtl/<m>.sv; chparam -set N <n> <m>;
          hierarchy -top <m>; proc; opt_expr; equiv_opt -assert peepopt"
```

| module | N=8 | N=16 |
|---|---|---|
| `mem_a` | Equivalence successfully proven | Equivalence successfully proven |
| `mem_b` | Equivalence successfully proven | Equivalence successfully proven |
| `mem_c` | Equivalence successfully proven | Equivalence successfully proven (68 min of SAT — the N=16 host port is a 256-way shifter) |

**One thing that looked alarming and is not.** The `peepopt` log reports
`mem_b.sv:63` with `index=\u_app_bar0.u_mem_a.h_sel` — mem_b's shifter indexed
by *mem_a's* select. That is `opt_merge` CSE after flattening: both modules
compute `h_sel` as the identical function of the identical `h_dw_addr`, so
Yosys keeps one wire and names it after the first. `mem_c` has a different word
count, so its compare differs and it keeps its own. The `equiv_opt` proofs above
are what settle it; the log line alone would not.

#### 3. Design-wide sweep for the *pattern* (the item I was asked to prioritize)

Every indexed part-select (`+:` / `-:`) in all 14 modules, classified by whether
its base is a compile-time constant:

| Site | Base | Verdict |
|---|---|---|
| `mm_array.sv` ×8, `mm_ctrl.sv` ×2, `mem_a/b.sv` ×6 each, `mem_c.sv:73-74` | genvar / static-loop integer | constant — cannot produce `$shiftx` |
| `mem_c.sv:98` (`ri * BOW'(N*ACCW)`) | integer in a **static** `for` — unrolls | constant |
| **`mem_c.sv:67`, `:103`** (`mem[h_boff +: 32]`, `h_boff = h_sel * ACCW`) | **variable**, zero constant base | proven equivalent under `peepopt` |
| **`mem_c.sv:101`** (`mem[d_boff +: N*ACCW]`, `d_boff = d_row * N*ACCW`) | **variable**, zero constant base | proven equivalent under `peepopt` |

**No other instance of the BUG-007 shape (variable offset + non-zero constant
base) exists anywhere in `rtl/`.** The only variable-base selects left are the
three `mem_c` sites, all zero-base, all covered by the proofs above.

#### 4. The check that would have caught this in minutes — now a reusable tool

Lint was clean, `yosys check` reported 0 problems, and 72 RTL tests passed, and
the design was still wrong. The only thing that detects this class is simulating
the **post-synthesis netlist**, and that needs no PDK: `synth -flatten` leaves
Yosys's own `$_AND_`/`$_DFF_P_` cells, and Yosys ships `simcells.v` defining
them, so Icarus runs the netlist directly.

`tb/gl/postsyn_replay.sh <N> [rtl-dir] [modules]` does this in ~4 minutes at
`N`=8 against a 2-hour ORFS flow. Results on the fixed RTL:

| `N` | post-synth replay |
|---|---|
| 2 | **72/72** |
| 4 | **72/72** |
| 8 | **72/72** |
| 16 | **72/72** — and `N`=16 is a configuration that was *broken* pre-fix (`mem_a` lost ports 12–13), so this is the strongest single result in the close-out |

**Recommendation to the orchestrator:** make this a standing gate between
Phase 3 and Phase 4. It is cheap, it is PDK-free, and it is the only barrier
this project has against a correct-simulating / wrong-synthesizing design.

**Files.** `rtl/mem_a.sv`, `rtl/mem_b.sv` (rtl-designer's fix);
`tb/gl/postsyn_replay.sh`, `tb/gl/postsyn_timescale.v` (my harness).
