pgratz1/pcie-matmul-rtl2gds/(list of files, drawings)

Other design files:
objects/sky130hd/pcie_matmul/base/klayout.lyt
objects/sky130hd/pcie_matmul/base_prebug007_negctrl/klayout.lyt
