pgratz1/pcie-matmul-rtl2gds/(commit log)

2026-09-11 phase-2b: review items closed, spec v1.1.2, 71/71 tests pass
    RTL: WIDTHCONCAT fixed properly (fires only at N=32; reset restructured to a
    per-row loop, zero suppressions), dangling sinks replaced with narrow
    UNUSEDSIGNAL pairs, config Length!=1 -> UR added, tx_tlp_data reset, dead
    app_rdata_last port deleted.
    Spec: v1.1.0 -> v1.1.2. REQ-123 off-by-one fixed by separating t_beat/t_start/
    t_commit; REQ-119 generalised over N; REQ-126 added for the config Length check.
    TB: 126/126 REQs mapped, 71/71 pass at two seeds.
    All gates verified independently by the orchestrator.
    Claude-Session: https://claude.ai/code/session_01HFv3sdAt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
    [app_bar0.sv, matmul_top.sv, mem_c.sv, mm_array.sv, mm_ctrl.sv, pcie_cfg_space.sv, reg_file.sv]
2026-09-11 phase-2b: round-2 review filed, zero Blocking items
    Reviewer verified the mem_c reset rewrite tiles exactly at every legal N,
    independently confirmed the REQ-126 classification path and REQ-042 bypass,
    and traced the +1178 cell delta to a non-folding loop index in mem_c.
    Claude-Session: https://claude.ai/code/session_01HFv3sdAtGvZ2LUDH9ZftwU
2026-09-11 phase-2b: cell-delta hypothesis refuted by measurement, REQ claims added
    mem_c synthesises to 22220 cells under all three reset forms; Yosys folds the
    loop index. The row loop is 83 cells cheaper than the original wide assignment,
    not 1178 dearer, so the delta is elsewhere. No speculative change made.
    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
    [matmul_top.sv, mem_c.sv, tlp_rx.sv]
2026-09-11 phase-3: gate MET, all six bugs closed with mutation-tested verification
    Validator injected 8 lint-clean RTL defects into a scratch copy and required the
    repaired tests to fail: BUG-002 killed by M5, BUG-003 by M6 (rx_tlp_ready held
    low 40 cycles post-eop, legal under REQ-002), BUG-005 by M2/M3, REQ-127 by M7/M8.
    One mutant survived; traced to the mutant being unreachable, not a weak test.
    check-build-id extended as an order-only prerequisite on the two file targets all
    entry points funnel through, closing regression/all/debug as well as sim.
    Evidence correction: distinct sim.vvp hashes do NOT prove per-N rebuilds
    (iverilog output is not byte-reproducible). Sound proof is behavioural --
    RE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
2026-09-11 phase-4: BUG-007 fixed -- Yosys peepopt mis-synthesised mem_a operand reads
    Root cause: non-zero constant base in a variable bit-offset
    (boff = BOW'(gi*N*8) + (BOW'(idx) << 3)) lowers to $shiftx; peepopt's
    shiftpow2 rewrote it incorrectly. RTL was legal; the tool was wrong.
    Pre-fix exposure: mem_a lost port 6 at N=8, ports 12-13 at N=16, ports 24-27
    at N=32 -- so N=16 and N=32 were broken too. mem_b clean at all N.
    Fix: explicit N-way mux over constant-base slices in mem_a.sv/mem_b.sv; no
    $shiftx, so the peephole cannot fire. 70148 -> 75665 cells, 6607 -> 6679 flops
    (logic the bug had been deleting).
    Verified: fresh synth gives all 8 PE rows uniform; RTL 72/72 at N=2/4/8/16 x2
    seeds; 18/18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
    [klayout.lyt]
2026-09-11 phase-4: GDS-II signed off -- 100 MHz, DRC 0, antenna 0, GL sim passes
    Re-run on fixed RTL closes 100 MHz first try, 0 of 4 closure iterations.
    Router DRC 0, KLayout signoff DRC 0, antenna 0 net / 0 pin (149 diodes).
    Setup 0 / hold 0, WNS/TNS 0.00, worst slack +0.05 ns; core fmax 125.69 MHz.
    55457 cells, die 1525570 um2, 40.38% util, 78.0 mW.
    Gate-level sim with SDF (94.2% annotation): 22 tests pass incl. the full
    test_matmul module 17/17 and 4 independent random 8x8 matmuls vs golden.
    C row 6 confirmed correct by four independent methods. X-prop clean across
    all 8 generate rows, 1088 PE nets.
    Run 1 preserved as base_prebug007_negctrl/ (BUG-007 negative control).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
    [klayout.lyt]
2026-09-11 phase-5: sign-off summary
    Final: 100 MHz, 55457 cells, 1525570 um2, 40.38% util, 78.0 mW, DRC 0,
    antenna 0, setup/hold 0. Nine recorded deviations from the kickoff baseline,
    29 agent invocations across six phases, 7 bugs found and closed.
    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
2026-09-11 chore: stop tracking generated build artifacts and PDK cell models
    tb/gl/build/ and tb/gl/postsyn/ held compiled .vvp simulation binaries (one
    294 MB, above GitHub's 100 MB per-file limit) and generated netlists.
    tb/gl/models_sdf/ and flow/gl_models/ are 1638 sky130 cell models regenerated
    by flow/make_gl_models.sh and tb/gl/build_sdf_models.py, both retained.
    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
2026-09-11 chore: gitignore ORFS objects/ alongside results, reports and logs
    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
    [klayout.lyt]
